simracingtools/hardware/starterbox/Reference.md

# Short reference

## Key / Button mappings

<table border="1">
	<tr><th>Function</th><th>Keyboard mapping</th><th>Joystick button</th></tr>
	<tr><td>Ignition</td><td>i</td><td>1</td>
	<tr><td>Starter</td><td>s</td><td>2</td>
	<tr><td>Pit limiter</td><td>p</td><td>3</td>
	<tr><td>TC Toggle</td><td>q</td><td>4</td>
	<tr><td>TC1</td><td>1 (-), 2 (+)</td><td>5 (-), 6 (+)</td>
	<tr><td>TC2</td><td>3 (-), 4 (+)</td><td>7 (-), 8 (+)</td>
	<tr><td>ABS Toggle</td><td>a</td><td>9</td>
	<tr><td>ABS</td><td>5 (-), 6 (+)</td><td>10 (-), 11 (+)</td>
	<tr><td>Fuel mix</td><td>7 (-), 8 (+)</td><td>12 (-), 13 (+)</td>
	<tr><td>Throttle shaping</td><td>9 (-), 0 (+)</td><td>14 (-), 15 (+)</td>
</table>

## Configuration

Enter configuration mode: Press ENG and ABS encoder while ignition is off.

Leave configuration mode: Switch ignition

<table border="1">
	<tr><th>Encoder</th><th>Function</th></tr>
	<tr>
		<td>ENG</td>
		<td>Change LED brightness by turning.</td>
	</tr>
	<tr>
		<td>ABS</td>
		<td>
			<p>Change encoder sensitivity by turning.</p>
			<p>Push to let blue LED blink according to current setting. The longer time it blinks, the less the sensitivity will be.</p>
		</td>
	</tr>
	<tr>
		<td>TC</td>
		<td>
			<p>Push to toggle between keyboard and joystick mode.</p>
			<p>Blue LED will blink when in joystick mode, red LED will blink when in keyboard mode.</p>
		</td>
	</tr>
</table>
