simracingtools/hardware/rccbox/images/BoxLayout.png

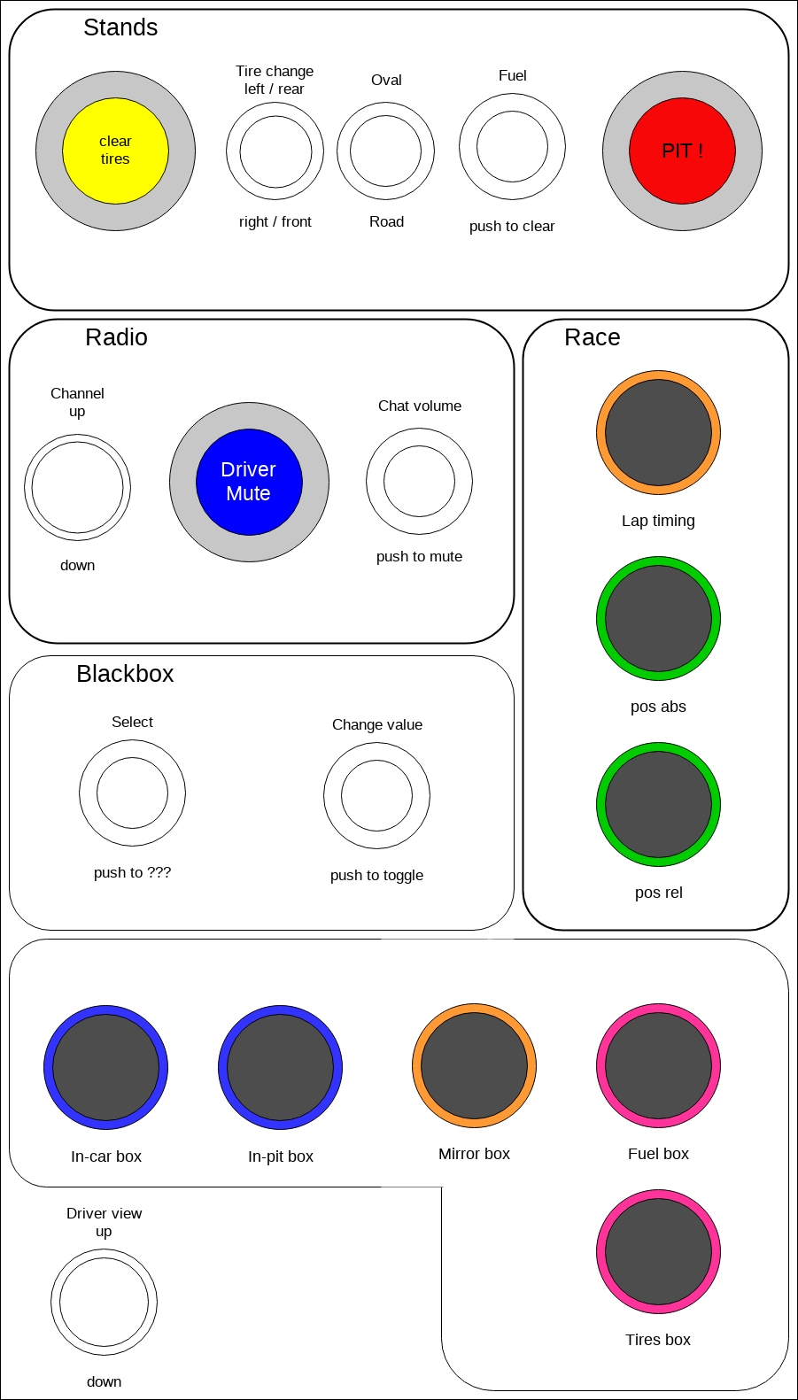
rccbox/images/BoxLayout.png
