simracingtools/hardware/starterbox/images/fullsize/BoxDecorated.jpg

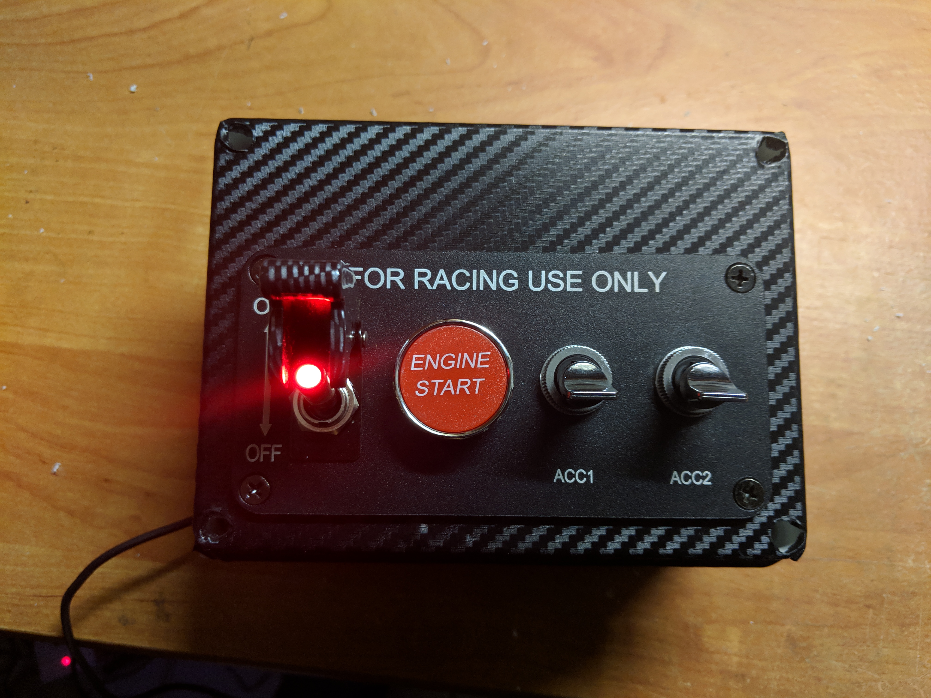
starterbox/images/fullsize/BoxDecorated.jpg
