simracingtools/hardware/starterbox/images/fullsize/BoxInsight.jpg

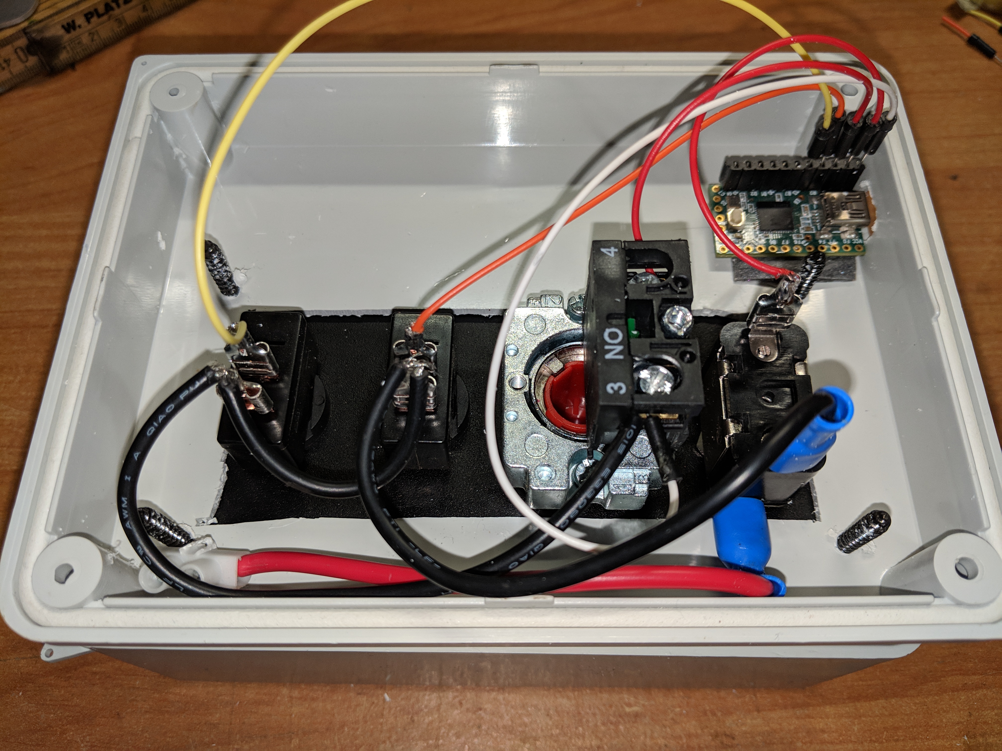
starterbox/images/fullsize/BoxInsight.jpg
