simracingtools/hardware/starterbox/images/fullsize/BoxMount.jpg

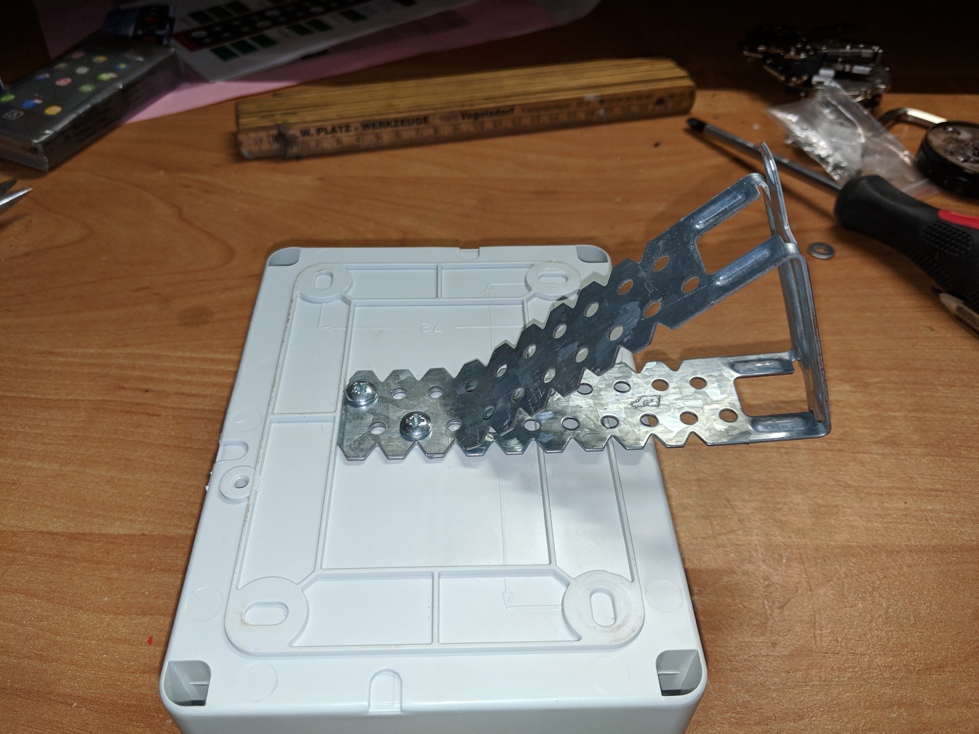
starterbox/images/fullsize/BoxMount.jpg
