simracingtools/hardware/starterbox/images/fullsize/BoxMounted.jpg

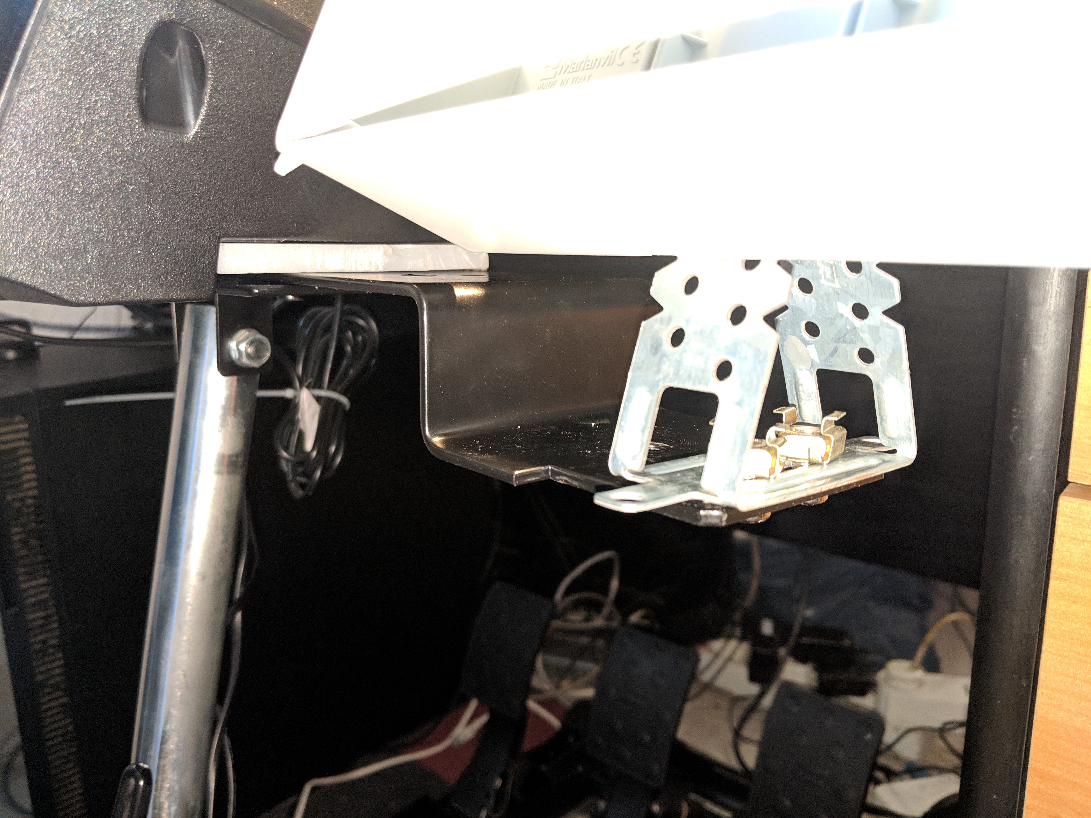
starterbox/images/fullsize/BoxMounted.jpg
