simracingtools/hardware/starterbox/images/fullsize/BoxWithEncoders.jpg

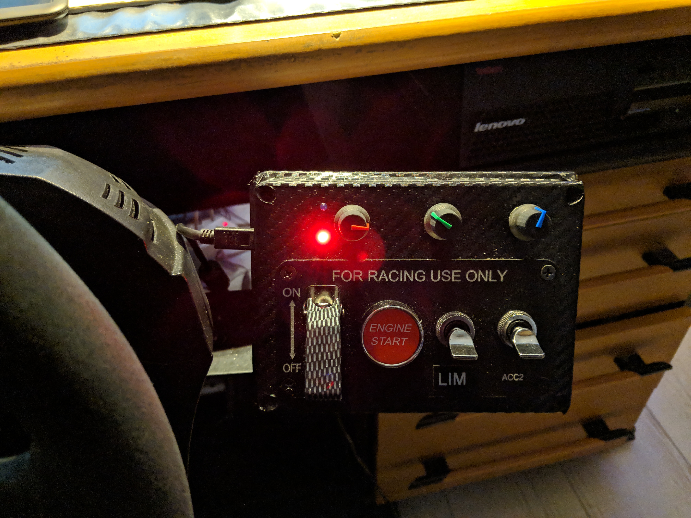
starterbox/images/fullsize/BoxWithEncoders.jpg
