simracingtools/hardware/starterbox/images/small/BoxFront.jpg

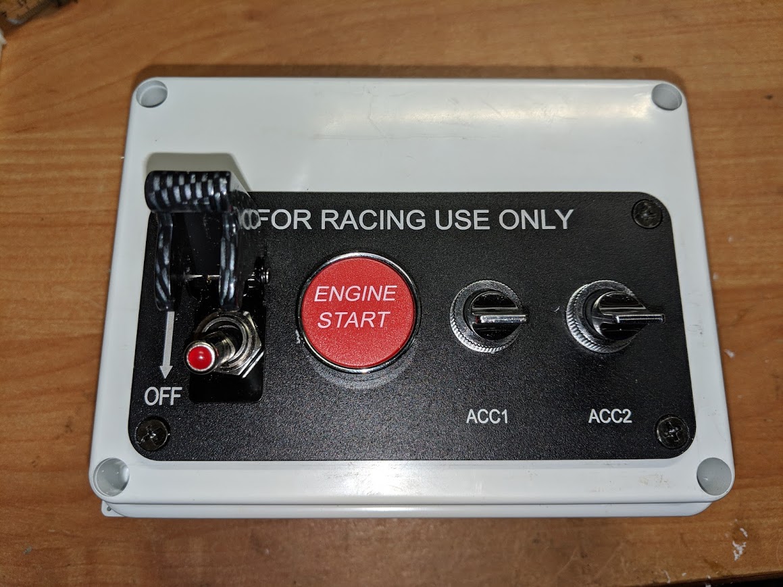
starterbox/images/small/BoxFront.jpg
