simracingtools/hardware/starterbox/images/small/BoxInPlace.jpg

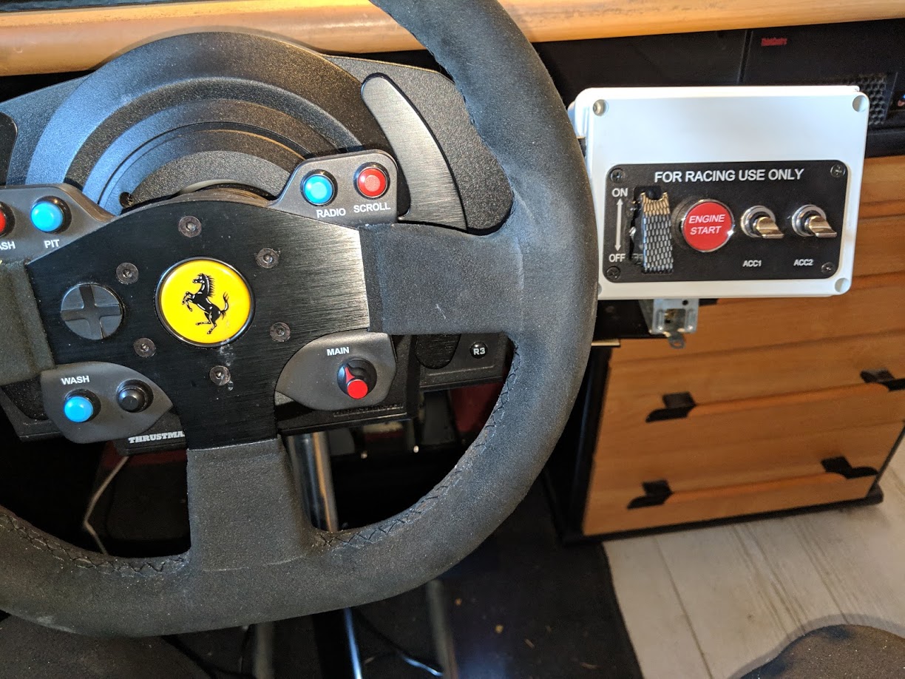
starterbox/images/small/BoxInPlace.jpg
