simracingtools/hardware/starterbox/images/small/BoxInPlaceDecorated.jpg

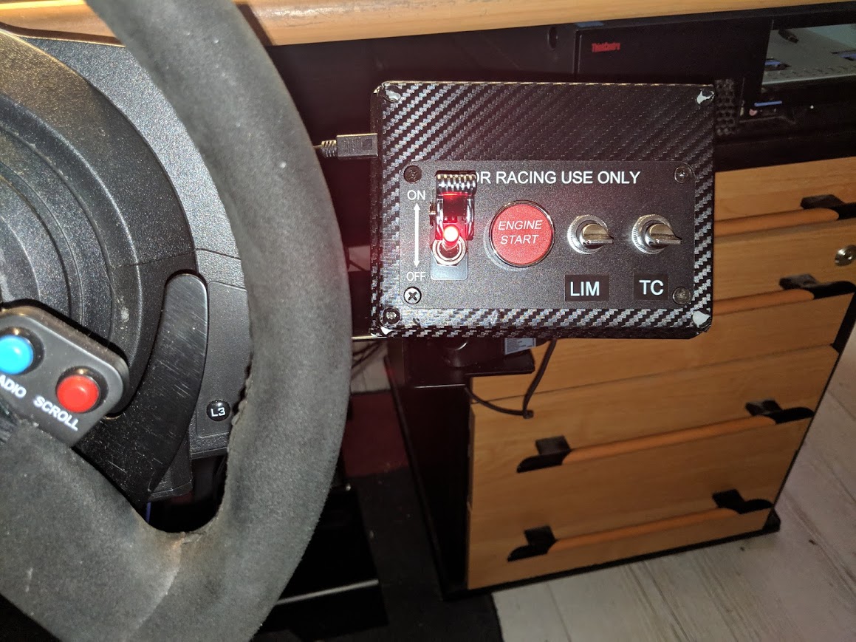
starterbox/images/small/BoxInPlaceDecorated.jpg
