simracingtools/hardware/v2rController/images/front.jpg

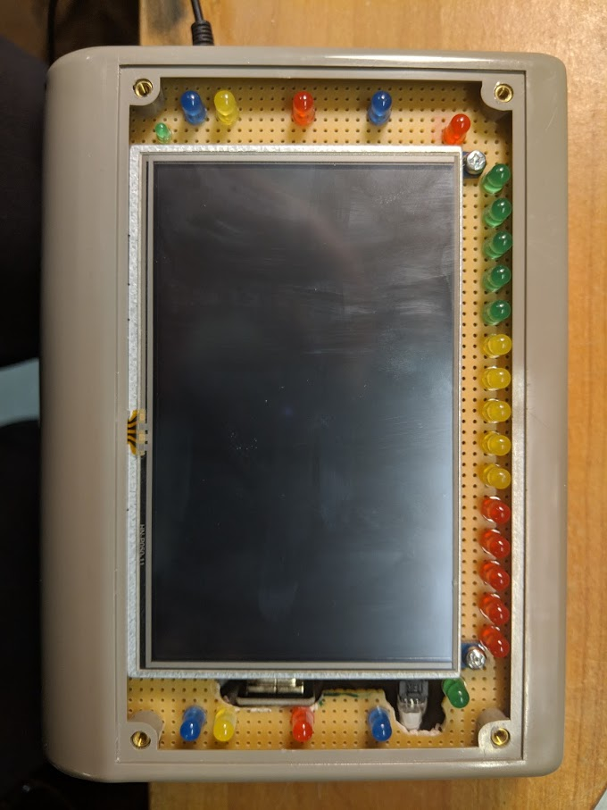
v2rController/images/front.jpg
