simracingtools/hardware/(commit log)

2019-03-31 wiring added
2019-03-31 software requirements and mounting
2019-04-22 starterbox with encoders
2019-04-22 Final version with encoders
2019-04-24 Added resistors for LED
2019-04-24 code reduced by using functions, control LED brightness by using PWM
2019-04-26 Simplified joystick button single press generation
2019-04-26 Wiring diagram update, use PWM pins for LED
2019-05-17 LED added
2019-05-17 Macros replaced with joystick buttons
    [config.h, iracing.ino]
2019-05-31 IRserial Arduino library
2019-10-07 improvements: state sync on driver change, automatic session type detection, towing and repair time, elapsed session time
2019-10-07 fix driver change
2019-10-08 print repair / towing
2019-10-24 renew driver index on session change
2019-10-28 better sync on driver change
2019-11-06 generate DriverChange events
